David-Alvarez-S/Proyecto-Integrador-de-Competencias-2/Evidencias 1/Cinta/Piñón principal.jpg

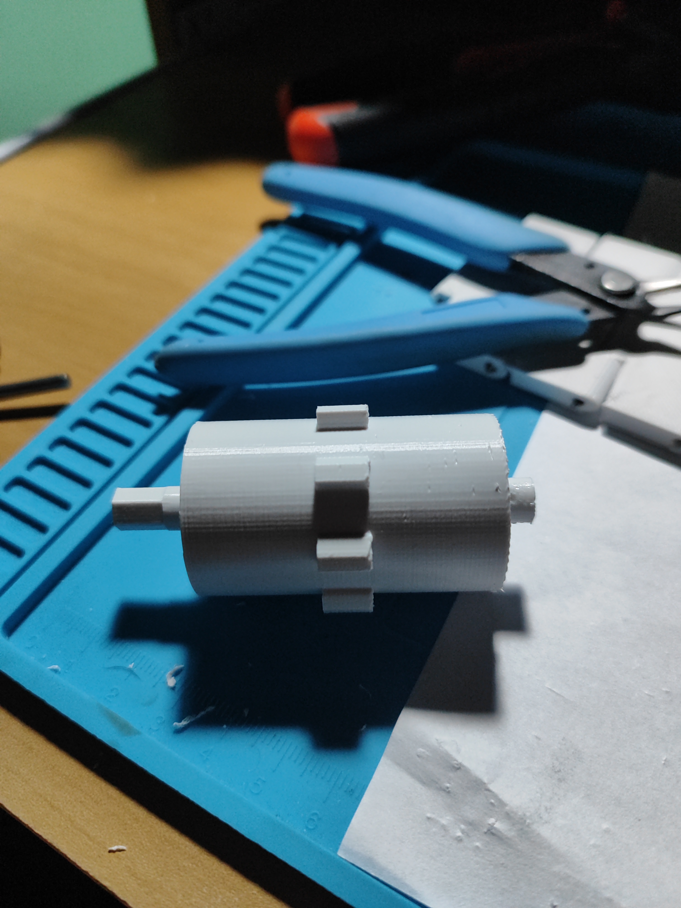
Evidencias 1/Cinta/Piñón principal.jpg
