David-Alvarez-S/Proyecto-Integrador-de-Competencias-2/Evidencias 1/Cinta/Piñón trasero.jpg

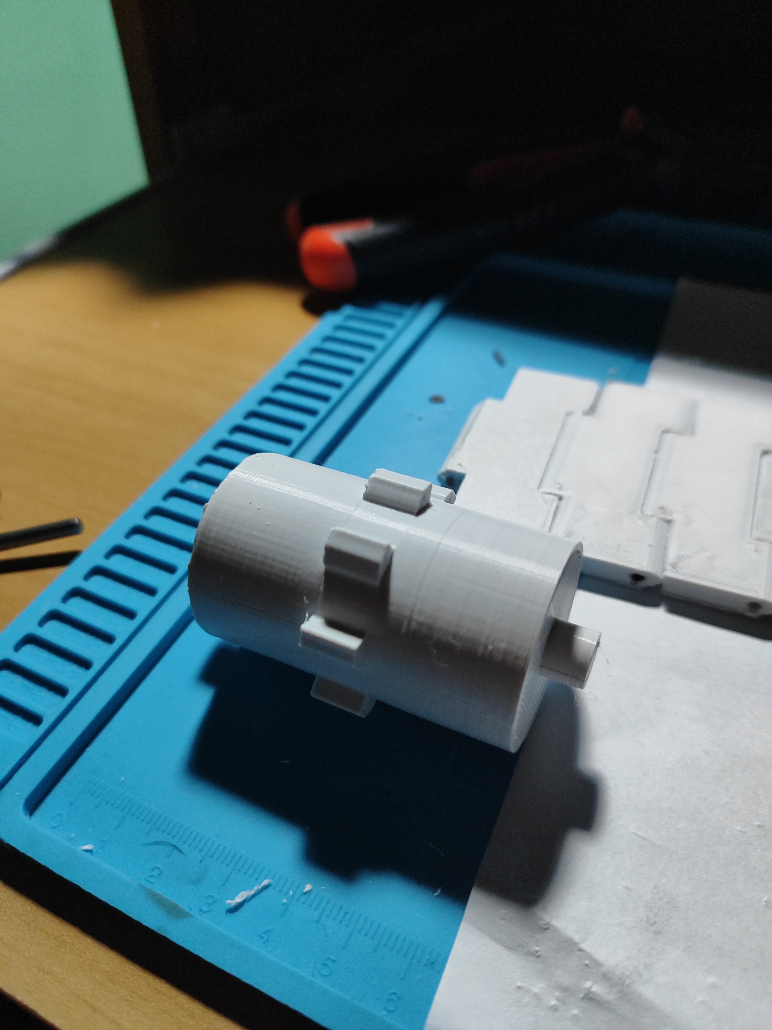
Evidencias 1/Cinta/Piñón trasero.jpg
