David-Alvarez-S/Proyecto-Integrador-de-Competencias-2/Evidencias 1/Contenedor/Marco frontal del contenedor.jpg

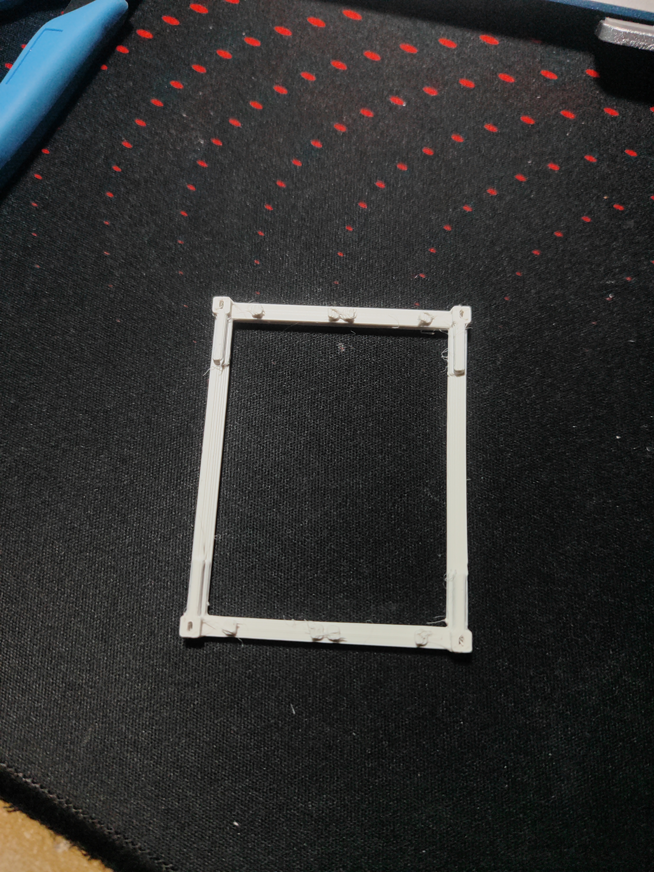
Evidencias 1/Contenedor/Marco frontal del contenedor.jpg
