David-Alvarez-S/Proyecto-Integrador-de-Competencias-2/Evidencias 1/Contenedor/Primer contenedor.jpg

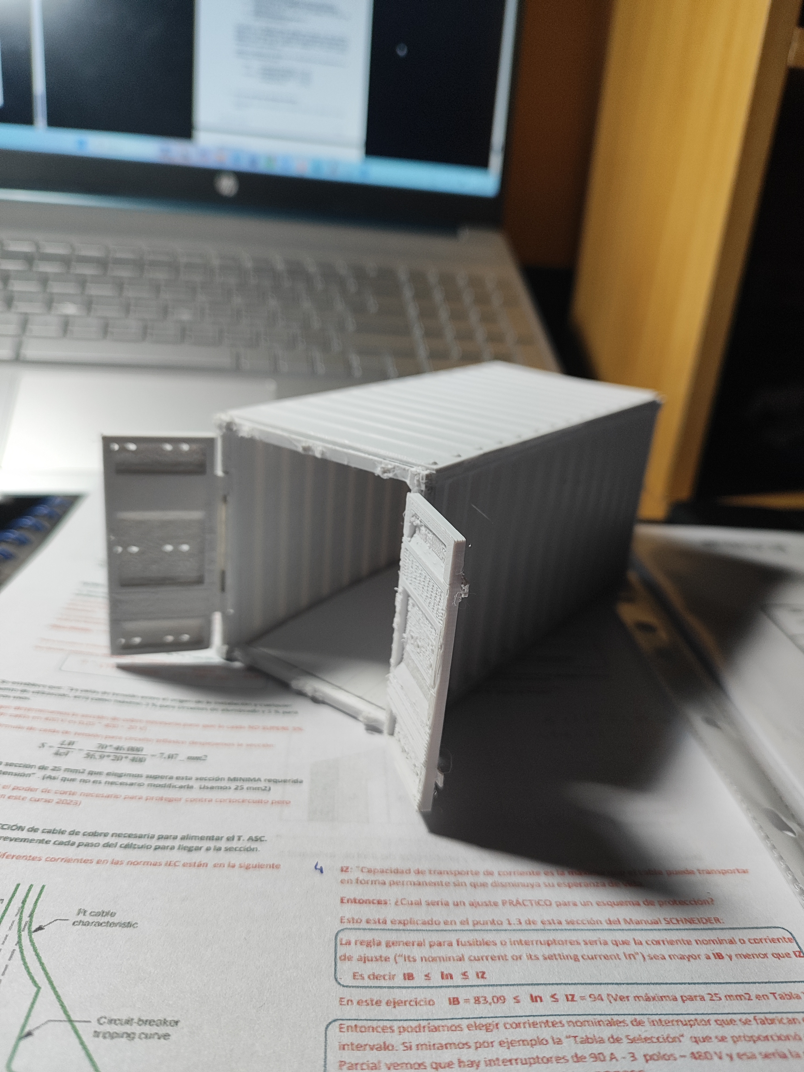
Evidencias 1/Contenedor/Primer contenedor.jpg
