David-Alvarez-S/Proyecto-Integrador-de-Competencias-2/Evidencias 1/Contenedor/Puerta izquierda y derecha del contenedor.jpg

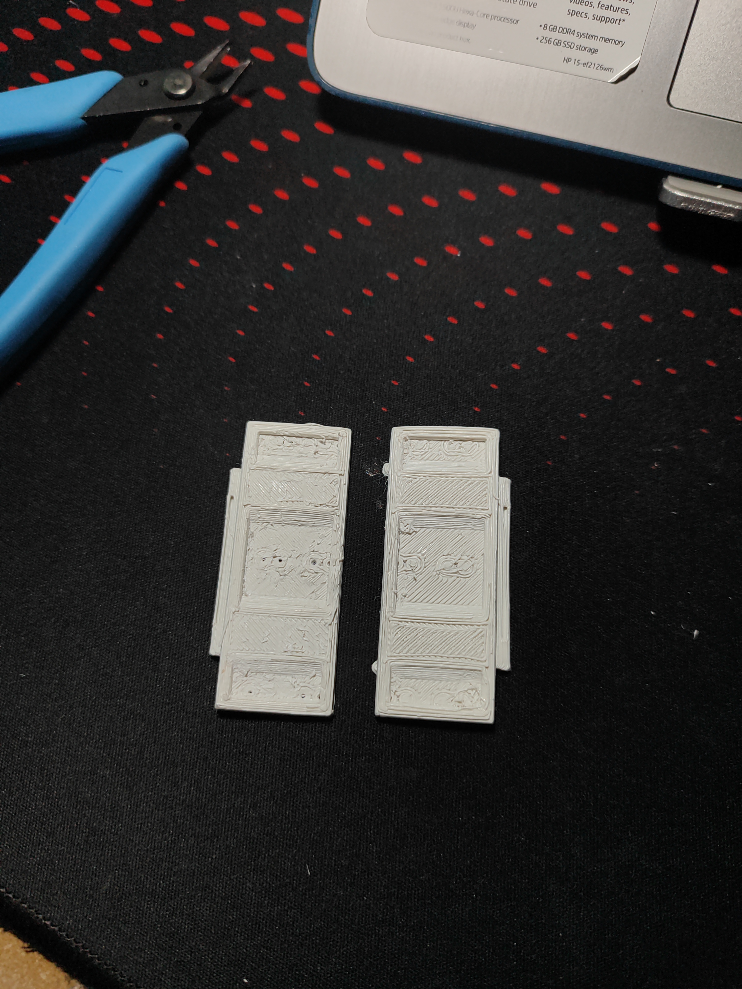
Evidencias 1/Contenedor/Puerta izquierda y derecha del contenedor.jpg
