David-Alvarez-S/Proyecto-Integrador-de-Competencias-2/Evidencias 1/Contenedor/Segundo contenedor.jpg

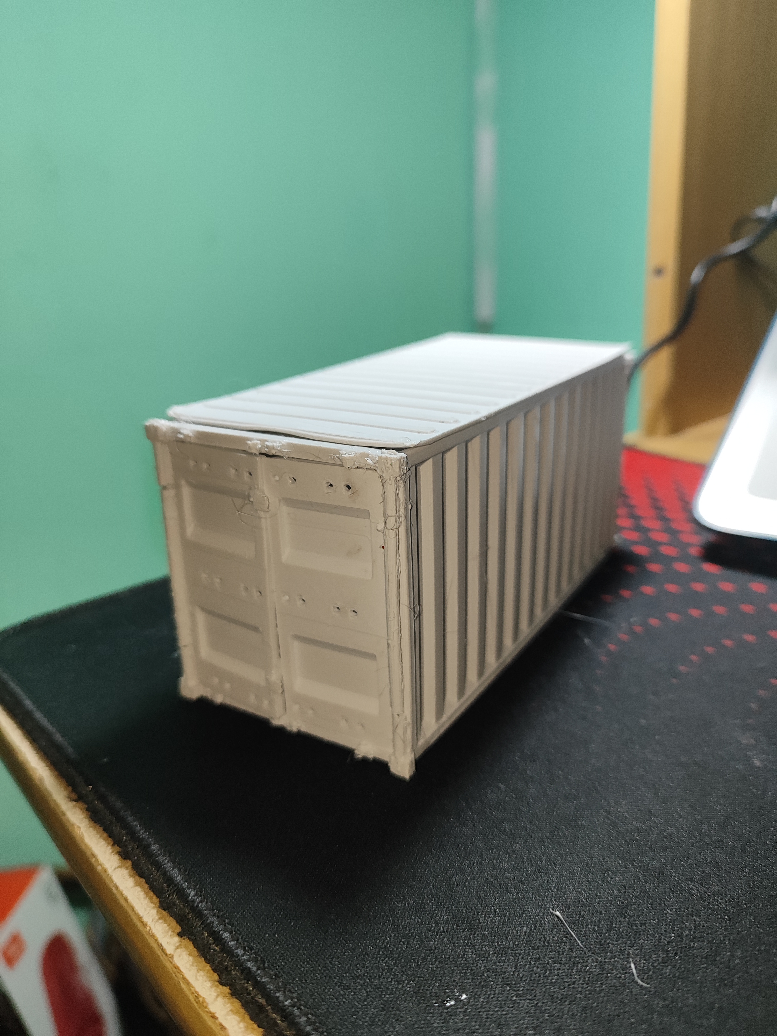
Evidencias 1/Contenedor/Segundo contenedor.jpg
