David-Alvarez-S/Proyecto-Integrador-de-Competencias-2/Evidencias 1/Contenedor/Soportes y piso del contenedor.jpg

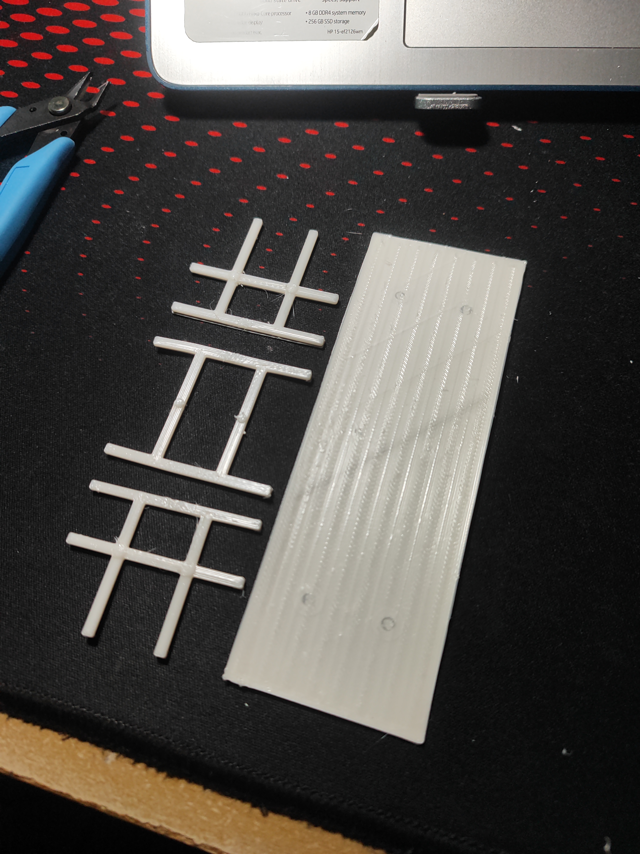
Evidencias 1/Contenedor/Soportes y piso del contenedor.jpg
