David-Alvarez-S/Proyecto-Integrador-de-Competencias-2/Evidencias 1/Diagramas/DiagramadeflujoPIC (1).png

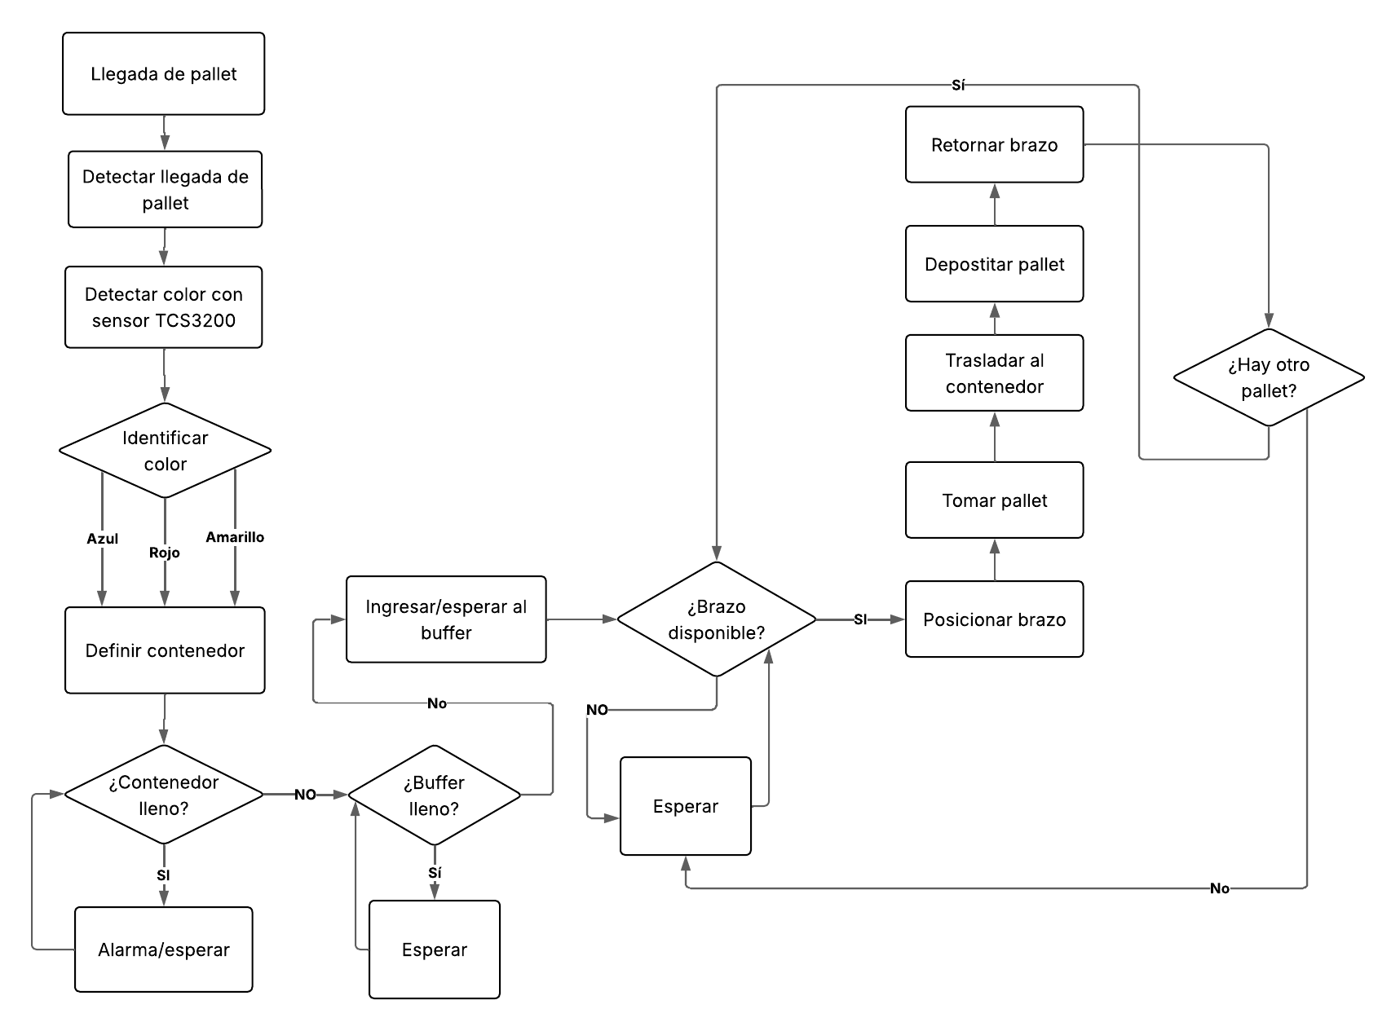
Evidencias 1/Diagramas/DiagramadeflujoPIC (1).png
