David-Alvarez-S/Proyecto-Integrador-de-Competencias-2/Evidencias 1/Diagramas/UMLPIC.drawio.png

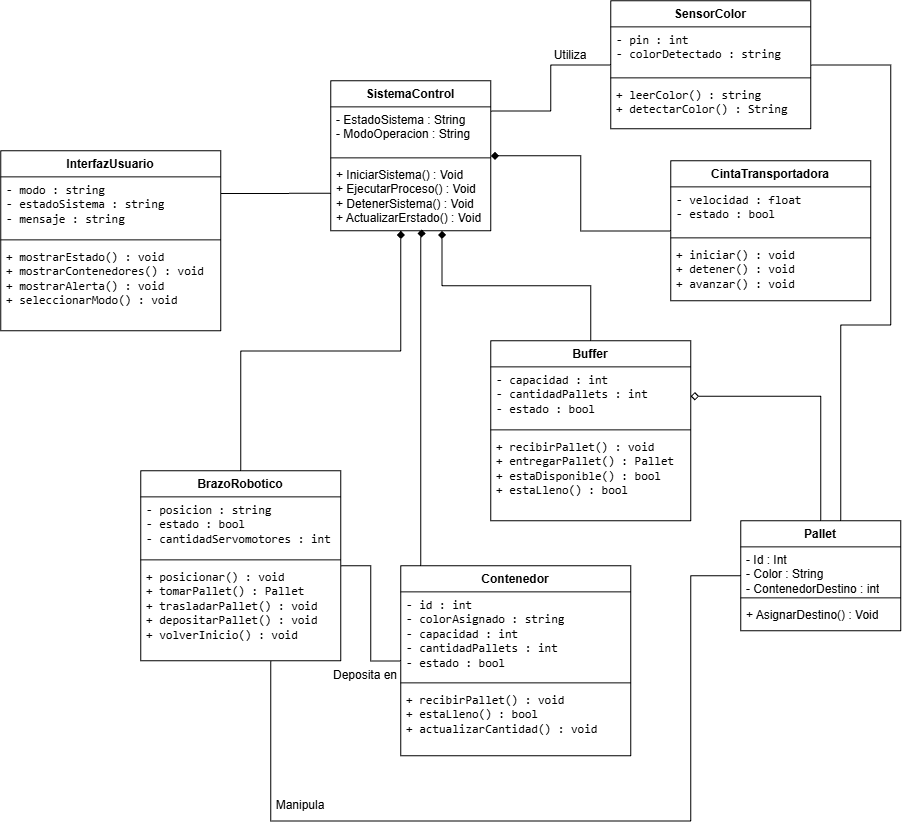
Evidencias 1/Diagramas/UMLPIC.drawio.png
