David-Alvarez-S/Proyecto-Integrador-de-Competencias-2/Evidencias 2/Carcasa de motor paso a paso/Carcasaparteinferior.stl

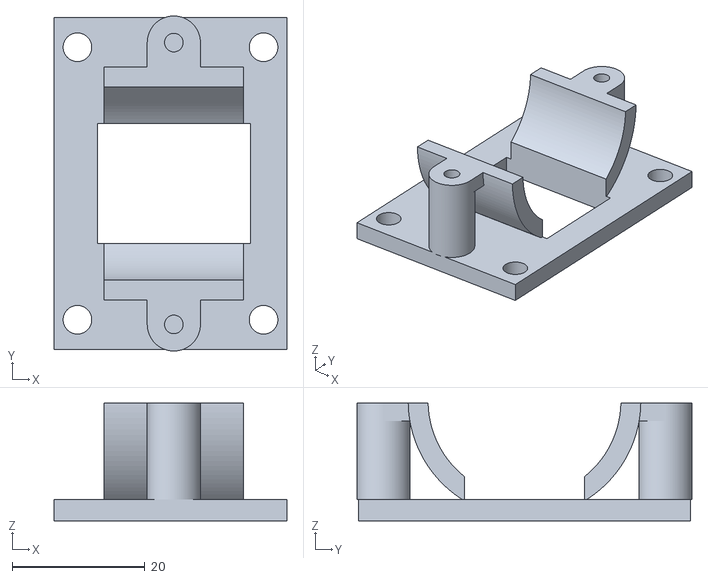
[picture p15: CAD file, 2026-09-30]
Evidencias 2/Carcasa de motor paso a paso/Carcasaparteinferior.stl
35.0 x 50.4 x 17.7
