David-Alvarez-S/Proyecto-Integrador-de-Competencias-2/Evidencias 2/Carcasa de sensor ultra sonido/Tapaultrasonido.stl

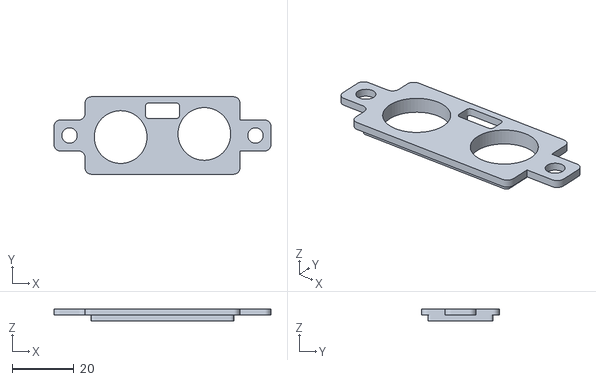
[picture p16: CAD file, 2026-10-01]
Evidencias 2/Carcasa de sensor ultra sonido/Tapaultrasonido.stl
70.0 x 25.0 x 4.00
