David-Alvarez-S/Proyecto-Integrador-de-Competencias-2/Evidencias 2/Carcasa de servo motor/Soportedeservo.stl

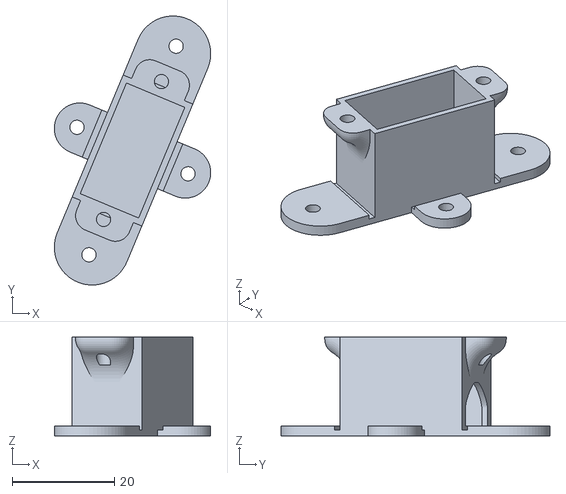
[picture p17: CAD file, 2026-09-30]
Evidencias 2/Carcasa de servo motor/Soportedeservo.stl
30.7 x 52.7 x 19.4
