David-Alvarez-S/Proyecto-Integrador-de-Competencias-2/Modelos 3D/Cinta transportadora/Lateral derecho/lateralderecho215,3.stl

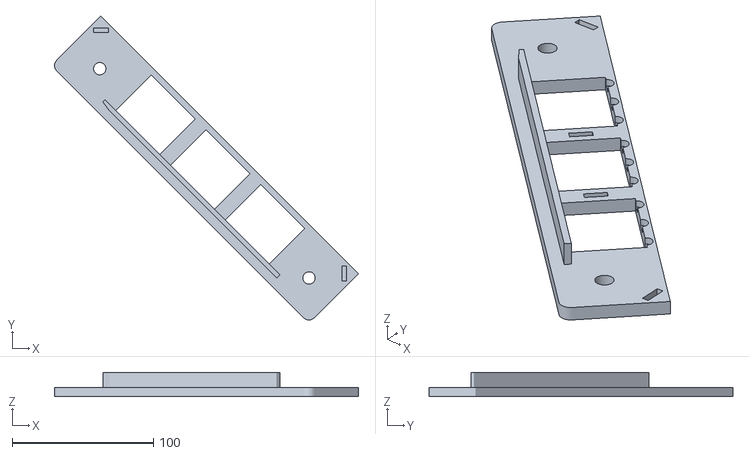
[picture p18: CAD file, 2026-09-14]
Modelos 3D/Cinta transportadora/Lateral derecho/lateralderecho215,3.stl
215.3 x 215.3 x 17.2
