David-Alvarez-S/Proyecto-Integrador-de-Competencias-2/Modelos 3D/Cinta transportadora/Perno/perno.stl

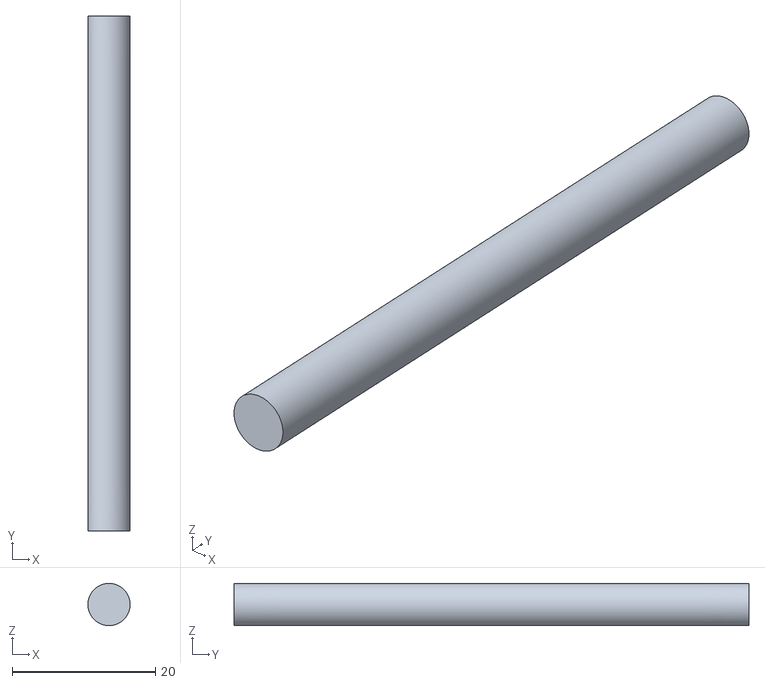
[picture p19: CAD file, 2026-09-14]
Modelos 3D/Cinta transportadora/Perno/perno.stl
5.90 x 72.0 x 5.90
