David-Alvarez-S/Proyecto-Integrador-de-Competencias-2/Modelos 3D/Cinta transportadora/Pieza de cinta/Piezacinta.stl

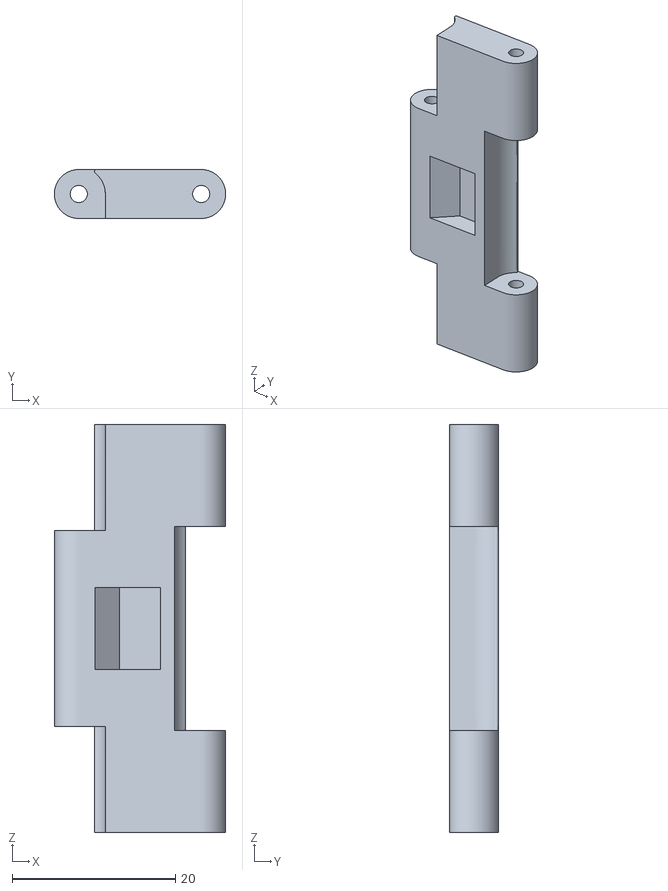
[picture p20: CAD file, 2026-09-14]
Modelos 3D/Cinta transportadora/Pieza de cinta/Piezacinta.stl
21.0 x 6.00 x 50.0
