David-Alvarez-S/Proyecto-Integrador-de-Competencias-2/Modelos 3D/Cinta transportadora/Piñón de cabeza/piñon de cabeza.stl

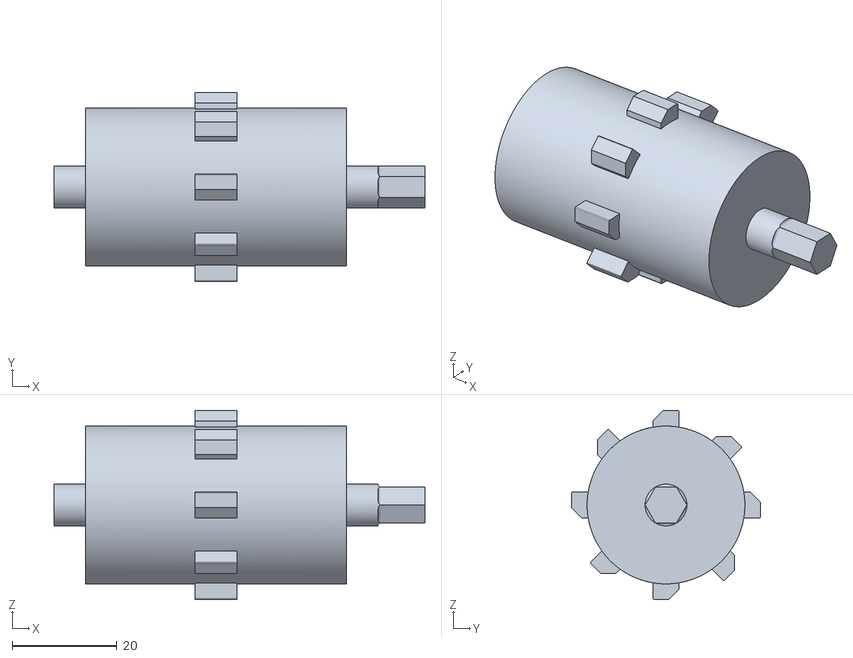
[picture p21: CAD file, 2026-09-14]
Modelos 3D/Cinta transportadora/Piñón de cabeza/piñon de cabeza.stl
71.0 x 36.2 x 36.2
