David-Alvarez-S/Proyecto-Integrador-de-Competencias-2/Modelos 3D/Cinta transportadora/Piñón trasero/piñon trasero.stl

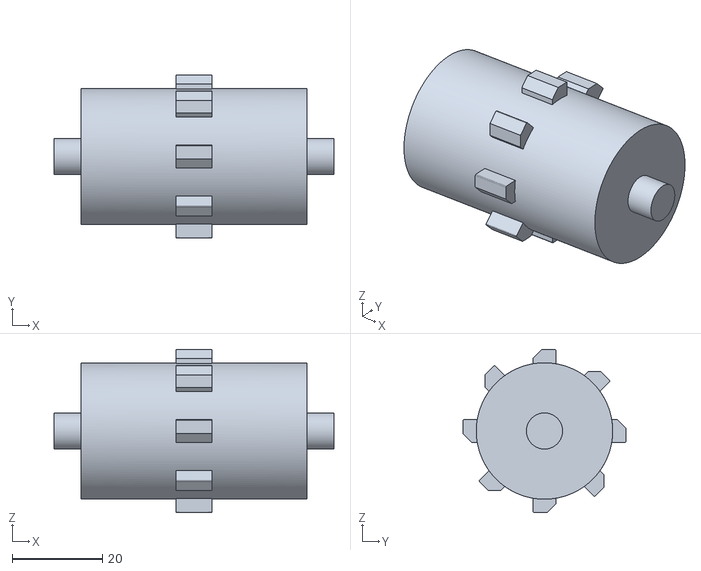
[picture p22: CAD file, 2026-09-14]
Modelos 3D/Cinta transportadora/Piñón trasero/piñon trasero.stl
62.0 x 36.2 x 36.2
