David-Alvarez-S/Proyecto-Integrador-de-Competencias-2/Modelos 3D/Cinta transportadora/Rectángulo soporte/rectangulosoporte.stl

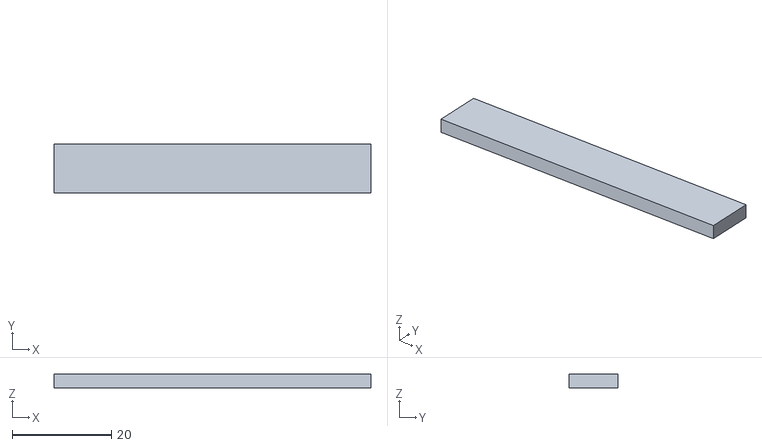
[picture p23: CAD file, 2026-09-14]
Modelos 3D/Cinta transportadora/Rectángulo soporte/rectangulosoporte.stl
64.0 x 9.80 x 2.80
