David-Alvarez-S/Proyecto-Integrador-de-Competencias-2/Modelos 3D/Contenedor/Fondo/fondo.stl

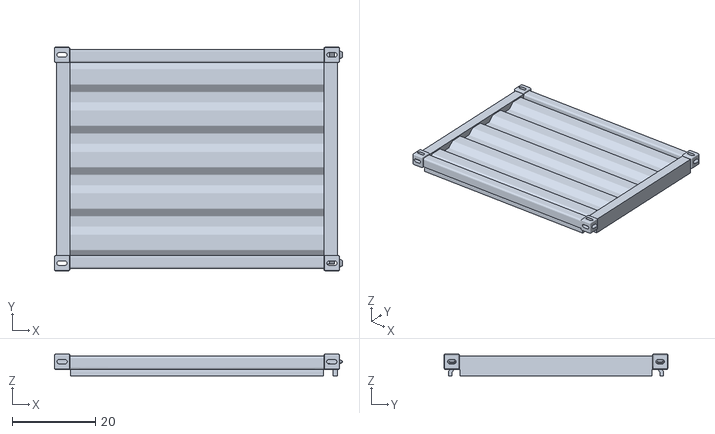
[picture p24: CAD file, 2026-09-10]
Modelos 3D/Contenedor/Fondo/fondo.stl
69.3 x 53.9 x 5.28
