David-Alvarez-S/Proyecto-Integrador-de-Competencias-2/Modelos 3D/Contenedor/Lateral derecho/lateral derecho.stl

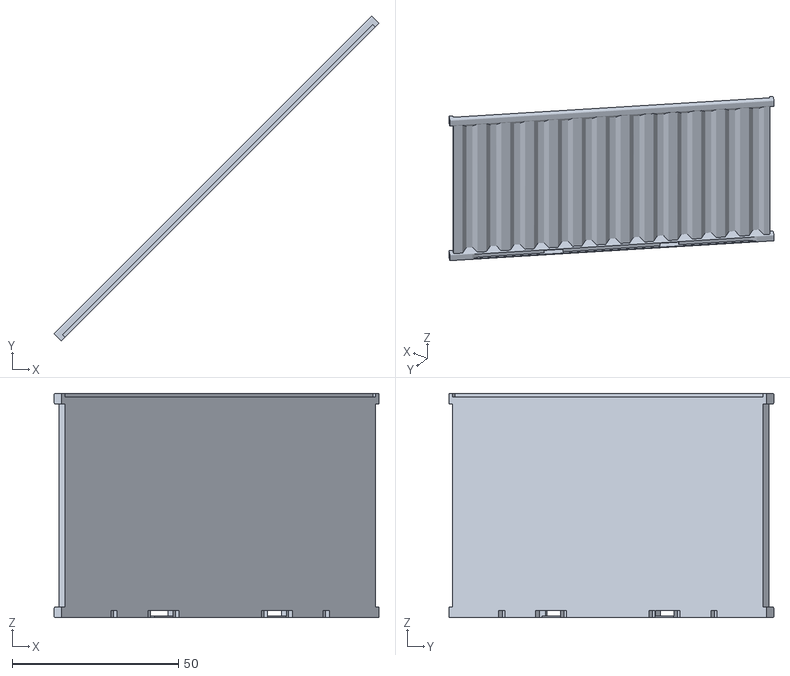
[picture p25: CAD file, 2026-09-10]
Modelos 3D/Contenedor/Lateral derecho/lateral derecho.stl
97.9 x 97.9 x 67.5
