David-Alvarez-S/Proyecto-Integrador-de-Competencias-2/Modelos 3D/Contenedor/Puerta derecha/puerta derecha.stl

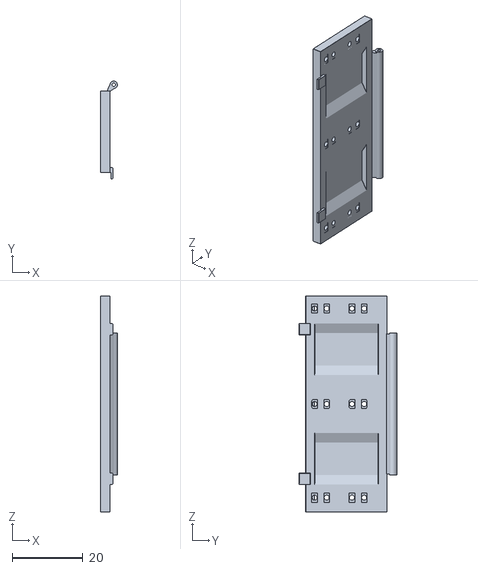
[picture p27: CAD file, 2026-09-10]
Modelos 3D/Contenedor/Puerta derecha/puerta derecha.stl
4.74 x 27.6 x 60.9
