David-Alvarez-S/Proyecto-Integrador-de-Competencias-2/Modelos 3D/Contenedor/Puerta izquierda/puerta izquierda.stl

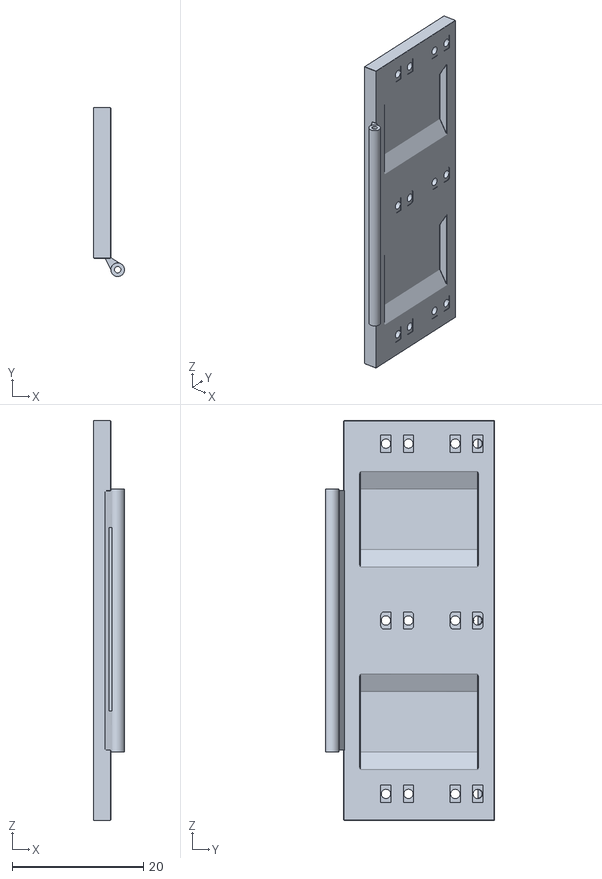
[picture p28: CAD file, 2026-09-10]
Modelos 3D/Contenedor/Puerta izquierda/puerta izquierda.stl
4.74 x 25.8 x 60.9
