David-Alvarez-S/Proyecto-Integrador-de-Competencias-2/Modelos 3D/Contenedor/Soportes y base inferior/soporte delantero.stl

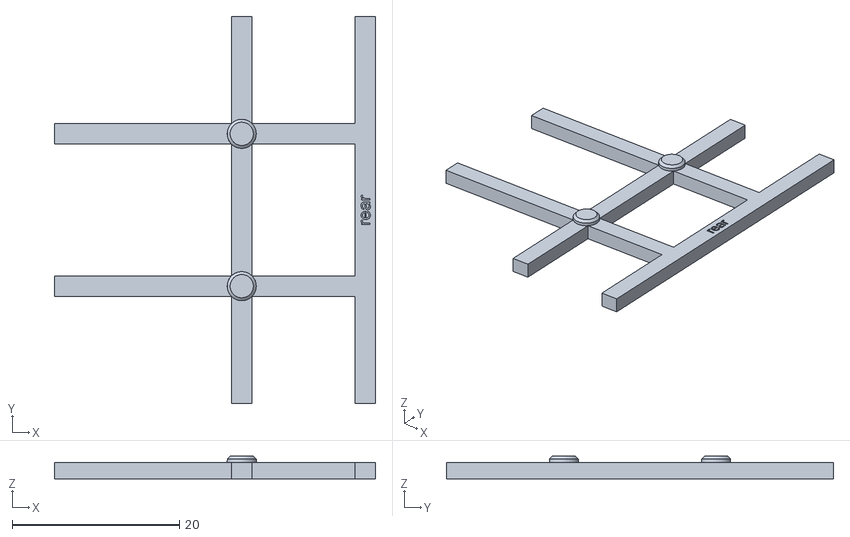
[picture p29: CAD file, 2026-09-10]
Modelos 3D/Contenedor/Soportes y base inferior/soporte delantero.stl
38.4 x 46.2 x 2.70
