David-Alvarez-S/Proyecto-Integrador-de-Competencias-2/Modelos 3D/Contenedor/Techo/techo.stl

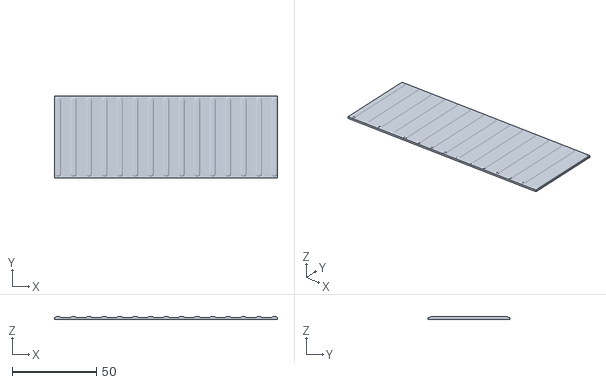
[picture p30: CAD file, 2026-09-10]
Modelos 3D/Contenedor/Techo/techo.stl
132.1 x 48.5 x 1.58
