David-Alvarez-S/Proyecto-Integrador-de-Competencias-2/Modelos 3D/Pallet/Pallet.stl

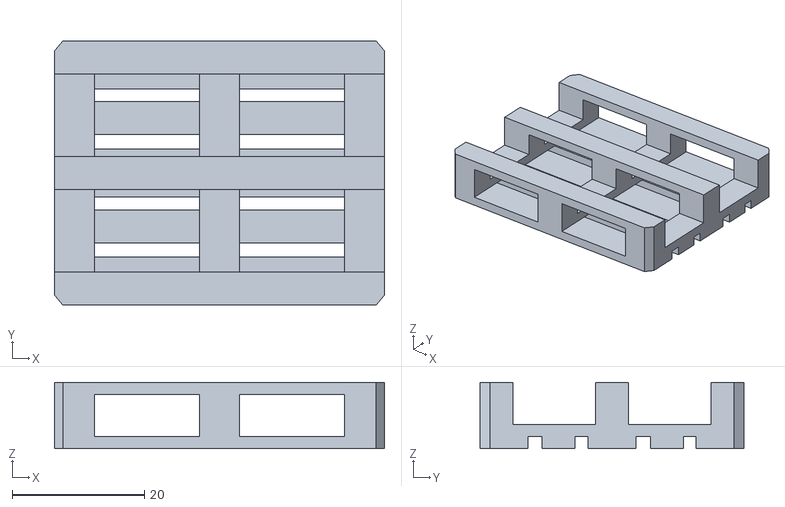
[picture p31: CAD file, 2026-09-10]
Modelos 3D/Pallet/Pallet.stl
50.0 x 40.0 x 10.0
