David-Alvarez-S/Proyecto-Integrador-de-Competencias-2/Modelos 3D/Porta pallets/Porta pallets.stl

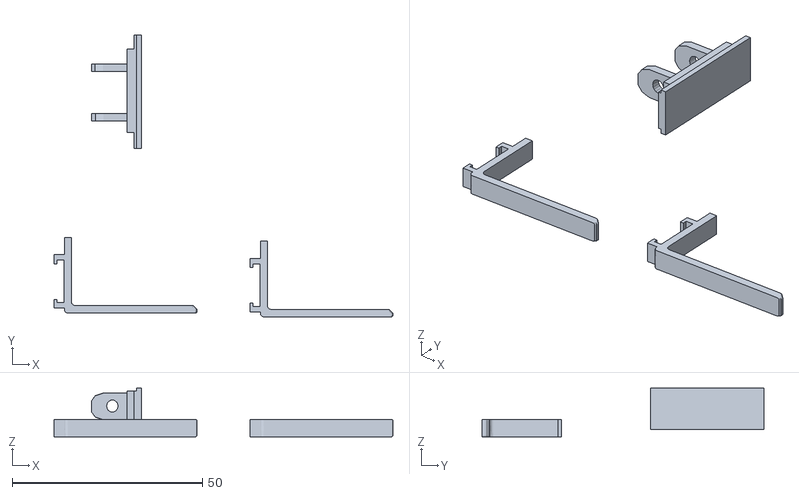
[picture p32: CAD file, 2026-09-10]
Modelos 3D/Porta pallets/Porta pallets.stl
89.0 x 74.0 x 12.8
