David-Alvarez-S/Proyecto-Integrador-de-Competencias-2/Evidencias 2/Carcasa de sensor ultra sonido/Baseultrasonido.stl

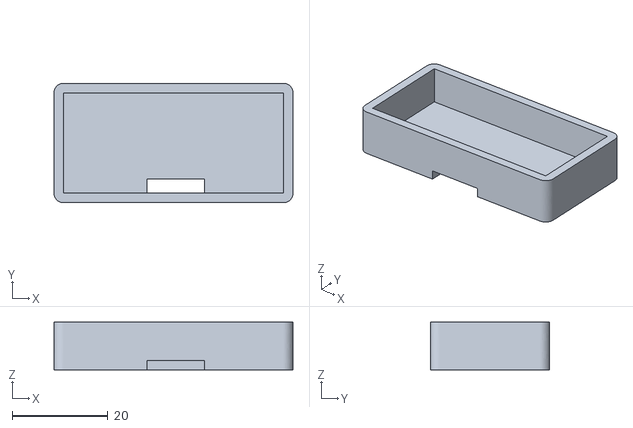
[picture p34: CAD file, 2026-10-01]
Evidencias 2/Carcasa de sensor ultra sonido/Baseultrasonido.stl
50.0 x 25.0 x 10.0
