David-Alvarez-S/Proyecto-Integrador-de-Competencias-2/Modelos 3D/Contenedor/Soportes y base inferior/soporte ultimo.stl

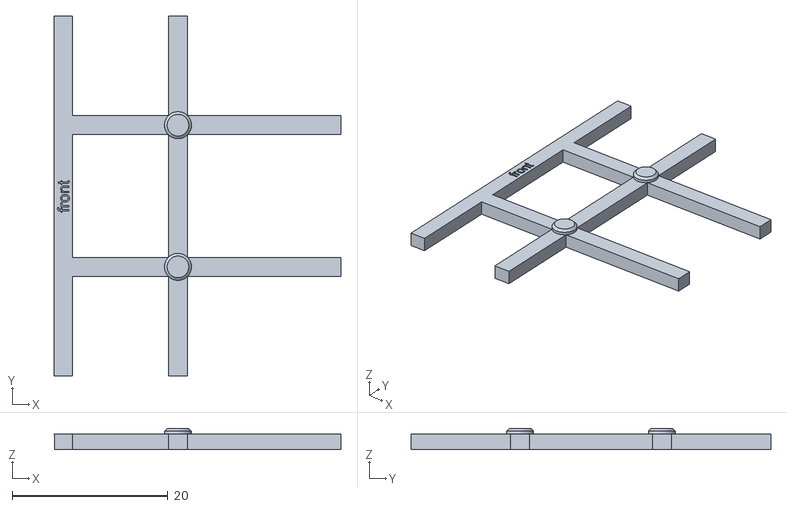
[picture p35: CAD file, 2026-09-10]
Modelos 3D/Contenedor/Soportes y base inferior/soporte ultimo.stl
36.8 x 46.2 x 2.70
