David-Alvarez-S/Proyecto-Integrador-de-Competencias-2/Modelos 3D/Contenedor/Soportes y base inferior/piso interior.stl

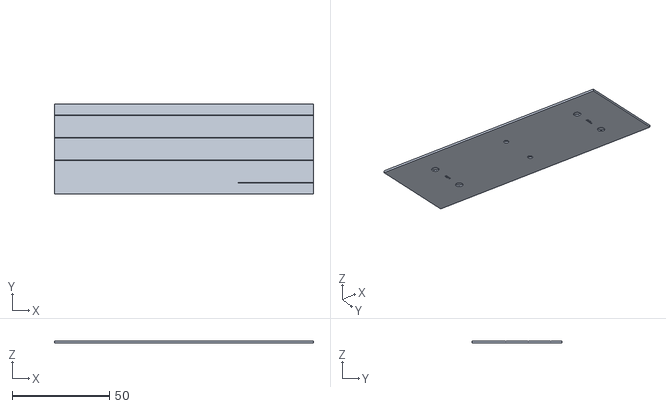
[picture p36: CAD file, 2026-09-10]
Modelos 3D/Contenedor/Soportes y base inferior/piso interior.stl
133.4 x 46.2 x 1.06
