David-Alvarez-S/Proyecto-Integrador-de-Competencias-2/(list of files, cad)

Other CAD files:
Modelos 3D/Cinta transportadora/Lateral izquierdo/lateralizquierdo215,3.stl
Modelos 3D/Contenedor/Lateral izquierdo/lateral izquierdo.stl
Modelos 3D/Contenedor/Soportes y base inferior/soporte medio.stl
Modelos 3D/Pallet/Pallet.f3d
Modelos 3D/Porta pallets/Porta pallets.f3d
