David-Alvarez-S/Proyecto-Integrador-de-Competencias-2/gemelo_digital_ros2/src/Descripcion_Brazo/assembly_1/urdf/assembly_1.urdf

<!--URDF generated by ONSHAPE BY PTC INC, 1.223-->
<robot name="descripcion_brazo/assembly_1">
    <link name="mg90s_servo">
        <inertial>
            <mass value="7.22604e-06" />
            <origin xyz="-0.0110128 -8.5652e-18 -0.00385467" rpy="0 -0 0" />
            <inertia ixx="4.98515e-10" ixy="0" ixz="-3.36919e-11" iyy="7.57509e-10" iyz="0" izz="4.24849e-10" />
        </inertial>
        <visual>
            <origin xyz="-0.0464 0.0003 -0.061" rpy="0 -0 0" />
            <geometry>
                <mesh filename="package://descripcion_brazo/assembly_1/meshes/mg90s_servo.gltf" scale="1 1 1" />
            </geometry>
            <material name="0.615686_0.811765_0.929412_0.000000_0.000000">
                <color rgba="0.615686 0.811765 0.929412 1" />
            </material>
        </visual>
    </link>
    <link name="mg90s_servo_1">
        <inertial>
            <mass value="7.22604e-06" />
            <origin xyz="-0.0110128 -8.5652e-18 -0.00385467" rpy="0 -0 0" />
            <inertia ixx="4.98515e-10" ixy="0" ixz="-3.36919e-11" iyy="7.57509e-10" iyz="0" izz="4.24849e-10" />
        </inertial>
        <visual>
            <origin xyz="-0.0464 0.0003 -0.061" rpy="0 -0 0" />
            <geometry>
                <mesh filename="package://descripcion_brazo/assembly_1/meshes/mg90s_servo.gltf" scale="1 1 1" />
            </geometry>
            <material name="0.615686_0.811765_0.929412_0.000000_0.000000">
                <color rgba="0.615686 0.811765 0.929412 1" />
            </material>
        </visual>
    </link>
    <link name="mg90s_servo_2">
        <inertial>
            <mass value="7.22604e-06" />
            <origin xyz="0.0117872 -5.09575e-18 -0.00385467" rpy="0 -0 0" />
            <inertia ixx="4.98515e-10" ixy="0" ixz="-3.36919e-11" iyy="7.57509e-10" iyz="0" izz="4.24849e-10" />
        </inertial>
        <visual>
            <origin xyz="-0.0236 0.0003 -0.061" rpy="0 -0 0" />
            <geometry>
                <mesh filename="package://descripcion_brazo/assembly_1/meshes/mg90s_servo.gltf" scale="1 1 1" />
            </geometry>
            <material name="0.615686_0.811765_0.929412_0.000000_0.000000">
                <color rgba="0.615686 0.811765 0.929412 1" />
            </material>
        </visual>
    </link>
    <link name="mg90s_servo_3">
        <inertial>
            <mass value="7.22604e-06" />
            <origin xyz="-0.0110128 -8.5652e-18 -0.00385467" rpy="0 -0 0" />
            <inertia ixx="4.98515e-10" ixy="0" ixz="-3.36919e-11" iyy="7.57509e-10" iyz="0" izz="4.24849e-10" />
        </inertial>
        <visual>
            <origin xyz="-0.0464 0.0003 -0.061" rpy="0 -0 0" />
            <geometry>
                <mesh filename="package://descripcion_brazo/assembly_1/meshes/mg90s_servo.gltf" scale="1 1 1" />
            </geometry>
            <material name="0.615686_0.811765_0.929412_0.000000_0.000000">
                <color rgba="0.615686 0.811765 0.929412 1" />
            </material>
        </visual>
    </link>
    <link name="part_1">
        <inertial>
            <mass value="0.0038" />
            <origin xyz="0.0110002 -1.47777e-05 0.000903451" rpy="0 -0 0" />
            <inertia ixx="1.33405e-07" ixy="-7.71669e-12" ixz="4.83833e-11" iyy="1.37752e-07" iyz="7.38176e-12" izz="2.68439e-07" />
        </inertial>
        <visual>
            <origin xyz="0.011 -4.33681e-19 0" rpy="0 -0 0" />
            <geometry>
                <mesh filename="package://descripcion_brazo/assembly_1/meshes/Part_1.gltf" scale="1 1 1" />
            </geometry>
            <material name="0.615686_0.811765_0.929412_0.000000_0.000000">
                <color rgba="0.615686 0.811765 0.929412 1" />
            </material>
        </visual>
    </link>
    <link name="part_1_1">
        <inertial>
            <mass value="8.24638e-06" />
            <origin xyz="9.01269e-07 -0.000747912 0.0125448" rpy="0 -0 0" />
            <inertia ixx="3.49713e-09" ixy="8.36438e-14" ixz="8.69225e-14" iyy="1.98224e-09" iyz="8.78835e-10" izz="2.31895e-09" />
        </inertial>
        <visual>
            <origin xyz="2.81893e-18 0.019 -0.001" rpy="0 -0 0" />
            <geometry>
                <mesh filename="package://descripcion_brazo/assembly_1/meshes/Part_1_1.gltf" scale="1 1 1" />
            </geometry>
            <material name="0.654902_0.823529_0.576471_0.000000_0.000000">
                <color rgba="0.654902 0.823529 0.576471 1" />
            </material>
        </visual>
    </link>
    <link name="part_1_10">
        <inertial>
            <mass value="6.59613e-07" />
            <origin xyz="3.07826e-19 -1.40946e-18 -0.001" rpy="0 0 -1.56788" />
            <inertia ixx="6.61644e-11" ixy="0" ixz="0" iyy="8.77608e-12" iyz="0" izz="7.45007e-11" />
        </inertial>
        <visual>
            <origin xyz="1.25645e-21 -4.30635e-19 -0.002" rpy="0 0 -1.56788" />
            <geometry>
                <mesh filename="package://descripcion_brazo/assembly_1/meshes/Part_1_4.gltf" scale="1 1 1" />
            </geometry>
            <material name="0.262745_0.282353_0.301961_0.000000_0.000000">
                <color rgba="0.262745 0.282353 0.301961 1" />
            </material>
        </visual>
    </link>
    <link name="part_1_11">
        <inertial>
            <mass value="6.59613e-07" />
            <origin xyz="-3.04127e-19 1.41027e-18 0.001" rpy="0 -0 1.57109" />
            <inertia ixx="6.61644e-11" ixy="0" ixz="0" iyy="8.77608e-12" iyz="0" izz="7.45007e-11" />
        </inertial>
        <visual>
            <origin xyz="-1.26413e-22 4.30637e-19 0" rpy="0 -0 1.57109" />
            <geometry>
                <mesh filename="package://descripcion_brazo/assembly_1/meshes/Part_1_4.gltf" scale="1 1 1" />
            </geometry>
            <material name="0.262745_0.282353_0.301961_0.000000_0.000000">
                <color rgba="0.262745 0.282353 0.301961 1" />
            </material>
        </visual>
    </link>
    <link name="part_1_12">
        <inertial>
            <mass value="0.0038" />
            <origin xyz="-0.0109998 -1.47777e-05 0.000903451" rpy="0 -0 0" />
            <inertia ixx="1.33405e-07" ixy="-7.71669e-12" ixz="4.83833e-11" iyy="1.37752e-07" iyz="7.38176e-12" izz="2.68439e-07" />
        </inertial>
        <visual>
            <origin xyz="-0.011 0 0" rpy="0 -0 0" />
            <geometry>
                <mesh filename="package://descripcion_brazo/assembly_1/meshes/Part_1.gltf" scale="1 1 1" />
            </geometry>
            <material name="0.615686_0.811765_0.929412_0.000000_0.000000">
                <color rgba="0.615686 0.811765 0.929412 1" />
            </material>
        </visual>
    </link>
    <link name="part_1_13">
        <inertial>
            <mass value="0.0038" />
            <origin xyz="2.1653e-07 -0.0110148 0.000903451" rpy="0 -0 0" />
            <inertia ixx="1.33405e-07" ixy="-7.71669e-12" ixz="4.83833e-11" iyy="1.37752e-07" iyz="7.38176e-12" izz="2.68439e-07" />
        </inertial>
        <visual>
            <origin xyz="0 -0.011 0" rpy="0 -0 0" />
            <geometry>
                <mesh filename="package://descripcion_brazo/assembly_1/meshes/Part_1.gltf" scale="1 1 1" />
            </geometry>
            <material name="0.615686_0.811765_0.929412_0.000000_0.000000">
                <color rgba="0.615686 0.811765 0.929412 1" />
            </material>
        </visual>
    </link>
    <link name="part_1_2">
        <inertial>
            <mass value="1.192e-05" />
            <origin xyz="-0.00611206 -1.95797e-18 0.0420483" rpy="0 -0 0" />
            <inertia ixx="1.84451e-08" ixy="0" ixz="2.87505e-09" iyy="1.9374e-08" iyz="0" izz="1.96571e-09" />
        </inertial>
        <visual>
            <origin xyz="-0.001 -1.84314e-18 -0.019" rpy="0 -0 0" />
            <geometry>
                <mesh filename="package://descripcion_brazo/assembly_1/meshes/Part_1_2.gltf" scale="1 1 1" />
            </geometry>
            <material name="0.874510_0.447059_0.317647_0.000000_0.000000">
                <color rgba="0.87451 0.447059 0.317647 1" />
            </material>
        </visual>
    </link>
    <link name="part_1_3">
        <inertial>
            <mass value="4.96156e-06" />
            <origin xyz="-0.00143353 -0.00249589 0.0233026" rpy="0 -0 0" />
            <inertia ixx="3.22542e-09" ixy="-8.2316e-13" ixz="7.68533e-12" iyy="3.0733e-09" iyz="3.6092e-10" izz="2.8758e-10" />
        </inertial>
        <visual>
            <origin xyz="-0.003 1.53081e-19 0" rpy="0 -0 0" />
            <geometry>
                <mesh filename="package://descripcion_brazo/assembly_1/meshes/Part_1_3.gltf" scale="1 1 1" />
            </geometry>
            <material name="0.760784_0.839216_0.925490_0.000000_0.000000">
                <color rgba="0.760784 0.839216 0.92549 1" />
            </material>
        </visual>
    </link>
    <link name="part_1_4">
        <inertial>
            <mass value="6.59613e-07" />
            <origin xyz="1.41044e-18 3.03308e-19 -0.001" rpy="0 0 -0.00028709" />
            <inertia ixx="6.61644e-11" ixy="0" ixz="0" iyy="8.77608e-12" iyz="0" izz="7.45007e-11" />
        </inertial>
        <visual>
            <origin xyz="4.30637e-19 -1.23632e-22 -0.002" rpy="0 0 -0.00028709" />
            <geometry>
                <mesh filename="package://descripcion_brazo/assembly_1/meshes/Part_1_4.gltf" scale="1 1 1" />
            </geometry>
            <material name="0.262745_0.282353_0.301961_0.000000_0.000000">
                <color rgba="0.262745 0.282353 0.301961 1" />
            </material>
        </visual>
    </link>
    <link name="part_1_5">
        <inertial>
            <mass value="1.2756e-05" />
            <origin xyz="0.00112439 0.00222137 0.0392417" rpy="0 -0 0" />
            <inertia ixx="2.12673e-08" ixy="-3.80215e-10" ixz="-5.47157e-09" iyy="2.39359e-08" iyz="-1.36345e-09" izz="4.73606e-09" />
        </inertial>
        <visual>
            <origin xyz="-0.001 -4.3097e-18 -0.019" rpy="0 -0 0" />
            <geometry>
                <mesh filename="package://descripcion_brazo/assembly_1/meshes/Part_1_5.gltf" scale="1 1 1" />
            </geometry>
            <material name="0.764706_0.545098_0.803922_0.000000_0.000000">
                <color rgba="0.764706 0.545098 0.803922 1" />
            </material>
        </visual>
    </link>
    <link name="part_1_6">
        <inertial>
            <mass value="0.0038" />
            <origin xyz="-3.47966e-06 -1.38568e-06 0.000903451" rpy="0 -0 0" />
            <inertia ixx="1.33405e-07" ixy="-7.71669e-12" ixz="4.83833e-11" iyy="1.37752e-07" iyz="7.38176e-12" izz="2.68439e-07" />
        </inertial>
        <visual>
            <origin xyz="-3.6962e-06 1.3392e-05 0" rpy="0 -0 0" />
            <geometry>
                <mesh filename="package://descripcion_brazo/assembly_1/meshes/Part_1.gltf" scale="1 1 1" />
            </geometry>
            <material name="0.615686_0.811765_0.929412_0.000000_0.000000">
                <color rgba="0.615686 0.811765 0.929412 1" />
            </material>
        </visual>
    </link>
    <link name="part_1_7">
        <inertial>
            <mass value="2.71405e-06" />
            <origin xyz="-1.89729e-18 -0.00104233 0.0181553" rpy="0 -0 0" />
            <inertia ixx="7.05277e-10" ixy="0" ixz="0" iyy="6.8784e-10" iyz="-1.35621e-10" izz="1.49349e-10" />
        </inertial>
        <visual>
            <origin xyz="-2.60209e-18 -0.0085 -0.003" rpy="0 -0 0" />
            <geometry>
                <mesh filename="package://descripcion_brazo/assembly_1/meshes/Part_1_6.gltf" scale="1 1 1" />
            </geometry>
            <material name="0.537255_0.854902_0.827451_0.000000_0.000000">
                <color rgba="0.537255 0.854902 0.827451 1" />
            </material>
        </visual>
    </link>
    <link name="part_1_8">
        <inertial>
            <mass value="2.42309e-05" />
            <origin xyz="-0.00448012 -2.42589e-07 -0.003443" rpy="0 -0 0" />
            <inertia ixx="1.24766e-08" ixy="-6.87656e-15" ixz="-5.61196e-10" iyy="1.33197e-08" iyz="-5.37657e-14" izz="2.29397e-08" />
        </inertial>
        <visual>
            <origin xyz="0 0 0" rpy="0 -0 0" />
            <geometry>
                <mesh filename="package://descripcion_brazo/assembly_1/meshes/Part_1_7.gltf" scale="1 1 1" />
            </geometry>
            <material name="0.647059_0.647059_0.647059_0.000000_0.000000">
                <color rgba="0.647059 0.647059 0.647059 1" />
            </material>
        </visual>
    </link>
    <link name="part_1_9">
        <inertial>
            <mass value="6.59613e-07" />
            <origin xyz="3.0453e-19 -1.41018e-18 -0.001" rpy="0 0 -1.57022" />
            <inertia ixx="6.61644e-11" ixy="0" ixz="0" iyy="8.77608e-12" iyz="0" izz="7.45007e-11" />
        </inertial>
        <visual>
            <origin xyz="2.49476e-22 -4.30637e-19 -0.002" rpy="0 0 -1.57022" />
            <geometry>
                <mesh filename="package://descripcion_brazo/assembly_1/meshes/Part_1_4.gltf" scale="1 1 1" />
            </geometry>
            <material name="0.262745_0.282353_0.301961_0.000000_0.000000">
                <color rgba="0.262745 0.282353 0.301961 1" />
            </material>
        </visual>
    </link>
    <link name="root" />
    <joint name="fastened_1" type="fixed">
        <origin xyz="0.0115 -1.68051e-18 0.003" rpy="0 -0 -3.14159" />
        <axis xyz="0 -1 0" />
        <parent link="part_1_8" />
        <child link="mg90s_servo_2" />
    </joint>
    <joint name="fastened_10" type="fixed">
        <origin xyz="-0.019 -1.10071e-05 3.46945e-18" rpy="0 -1.5708 0.000579319" />
        <axis xyz="0 0 -1" />
        <parent link="part_1_9" />
        <child link="part_1_2" />
    </joint>
    <joint name="fastened_11" type="fixed">
        <origin xyz="-4.15588e-16 -5.55112e-17 -0.002" rpy="0 -1.5708 1.57051" />
        <axis xyz="-1 0 0" />
        <parent link="part_1_4" />
        <child link="part_1_3" />
    </joint>
    <joint name="fastened_12" type="fixed">
        <origin xyz="-0.001 1.01578e-15 0.096" rpy="0 -1.5708 -3.09264e-16" />
        <axis xyz="0 0 -1" />
        <parent link="part_1_2" />
        <child link="mg90s_servo_1" />
    </joint>
    <joint name="fastened_14" type="fixed">
        <origin xyz="-0.025 3.2793e-16 0.102073" rpy="0 1.5708 1.49084e-16" />
        <axis xyz="1 -1.16424e-16 -0" />
        <parent link="part_1_2" />
        <child link="part_1" />
    </joint>
    <joint name="fastened_15" type="fixed">
        <origin xyz="0.027 2.4626e-16 0.086735" rpy="0 -1.5708 -1.44704e-15" />
        <axis xyz="0 0 -1" />
        <parent link="part_1_5" />
        <child link="part_1_6" />
    </joint>
    <joint name="fastened_2" type="fixed">
        <origin xyz="-0.0189999 -5.54354e-05 0" rpy="-6.16298e-32 -6.14502e-32 -1.56788" />
        <axis xyz="1 0 0" />
        <parent link="part_1_10" />
        <child link="part_1_1" />
    </joint>
    <joint name="fastened_3" type="fixed">
        <origin xyz="1.40166e-18 6.93889e-18 0.04215" rpy="1.5708 4.85723e-17 -2.22045e-16" />
        <axis xyz="-0 -0 -1" />
        <parent link="part_1_7" />
        <child link="part_1_13" />
    </joint>
    <joint name="fastened_4" type="fixed">
        <origin xyz="0.0255 8.67362e-19 0.0255" rpy="1.5708 -0 -1.5708" />
        <axis xyz="-0 -1 -0" />
        <parent link="part_1_8" />
        <child link="part_1_7" />
    </joint>
    <joint name="fastened_5" type="fixed">
        <origin xyz="-2.51061e-18 0.0015 0.037" rpy="0 -1.5708 4.71239" />
        <axis xyz="0 -1 0" />
        <parent link="part_1_1" />
        <child link="mg90s_servo" />
    </joint>
    <joint name="fastened_6" type="fixed">
        <origin xyz="0.019 5.57745e-06 1.73472e-18" rpy="0 1.5708 0.00029355" />
        <axis xyz="-1 0 0" />
        <parent link="part_1_11" />
        <child link="part_1_5" />
    </joint>
    <joint name="fastened_8" type="fixed">
        <origin xyz="0.002 4.60549e-17 0.093" rpy="0 -1.5708 3.14159" />
        <axis xyz="0 0 -1" />
        <parent link="part_1_5" />
        <child link="mg90s_servo_3" />
    </joint>
    <joint name="fastened_9" type="fixed">
        <origin xyz="-9.52065e-19 -0.0187 0.04235" rpy="0 -1.5708 1.5708" />
        <axis xyz="-0 -0 -1" />
        <parent link="part_1_1" />
        <child link="part_1_12" />
    </joint>
    <joint name="fixed_node_to_root_joint" type="fixed">
        <origin xyz="0 0 0" rpy="0 -0 0" />
        <axis xyz="0 0 1" />
        <parent link="root" />
        <child link="part_1_8" />
    </joint>
    <joint name="revolute_1" type="continuous">
        <origin xyz="0.01715 -1.02259e-18 0.0145" rpy="8.35204e-16 1.63256e-16 3.14159" />
        <axis xyz="0 0 -1" />
        <parent link="mg90s_servo_2" />
        <child link="part_1_10" />
    </joint>
    <joint name="revolute_2" type="continuous">
        <origin xyz="-0.00565 -4.16401e-18 0.0145" rpy="-3.14159 -6.42975e-17 -2.01023e-16" />
        <axis xyz="0 0 -1" />
        <parent link="mg90s_servo" />
        <child link="part_1_11" />
    </joint>
    <joint name="revolute_3" type="continuous">
        <origin xyz="-0.00565 -2.51561e-16 0.0145" rpy="4.68367e-17 -5.84448e-16 3.14159" />
        <axis xyz="0 0 1" />
        <parent link="mg90s_servo_3" />
        <child link="part_1_9" />
    </joint>
    <joint name="revolute_4" type="continuous">
        <origin xyz="-0.00565 -3.63208e-18 0.0145" rpy="3.14159 1.44227e-16 -1.5708" />
        <axis xyz="0 0 -1" />
        <parent link="mg90s_servo_1" />
        <child link="part_1_4" />
    </joint>
</robot>
