David-Alvarez-S/Proyecto-Integrador-de-Competencias-2/Modelos 3D/Pallet/Plano de pallet.pdf

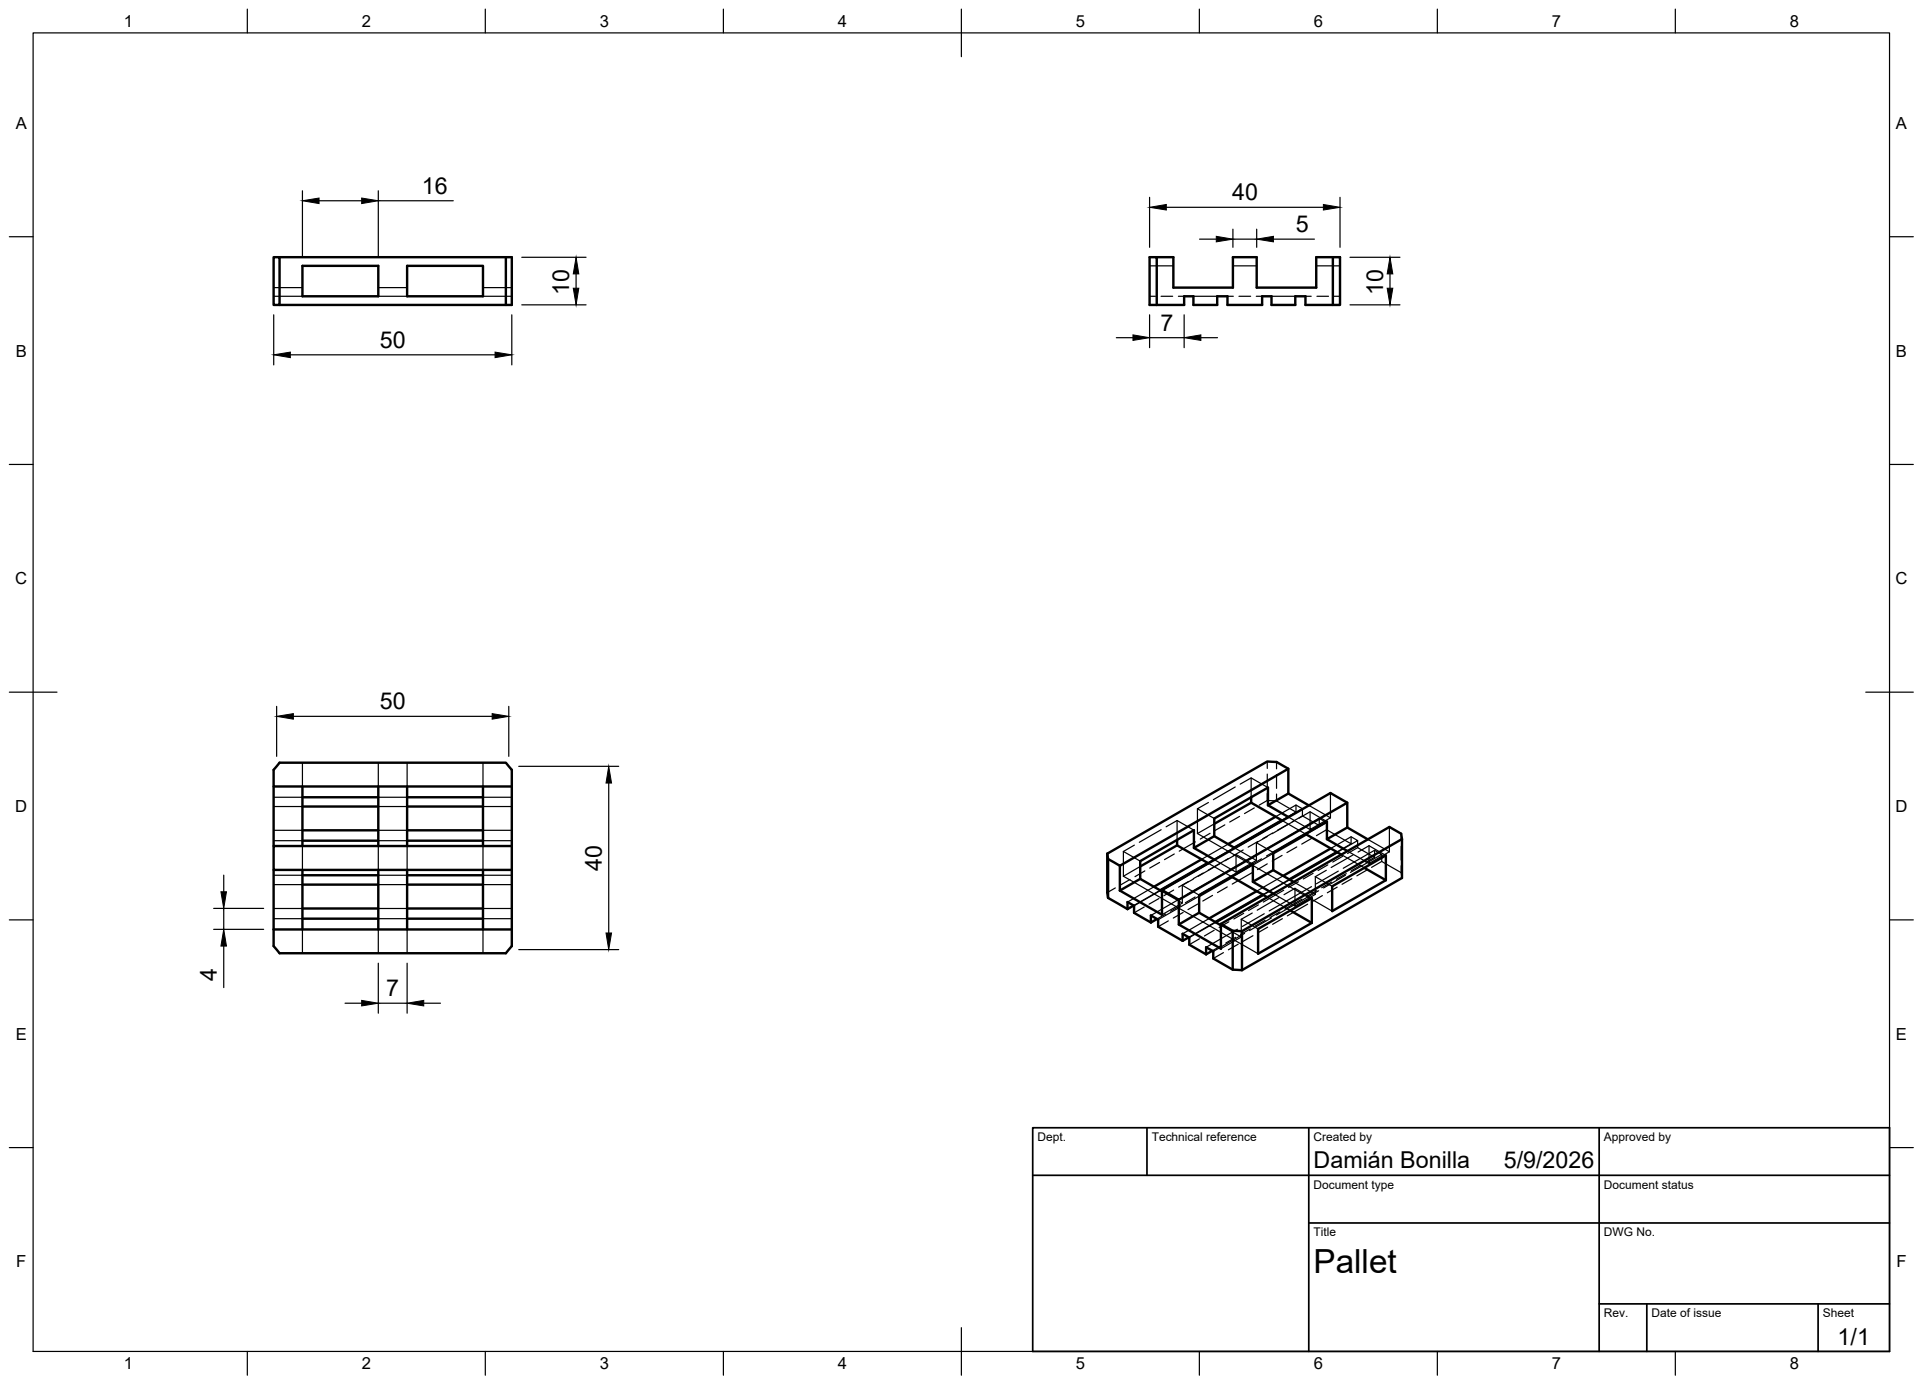
[picture p37: page 1]
Title; DWG No.; Rev.; Date of issue; Sheet; Damián Bonilla 10

Dept. | Technical reference | Created by 5/9/2026 | Approved by

Document type | Document status
