David-Alvarez-S/Proyecto-Integrador-de-Competencias-2/codigo/PlatformIO_code/include/Drivers/tft_font5x7.h

#ifndef TFT_FONT5X7_H
#define TFT_FONT5X7_H

#ifdef __cplusplus
extern "C" {
#endif

#include <stdint.h>

#define TFT_FONT_GLYPH_W 5
#define TFT_FONT_CELL_W 6
#define TFT_FONT_CELL_H 8

static inline const uint8_t *tft_font5x7_glyph(char c) {
  static const uint8_t font[95][5] = {
      {0x00, 0x00, 0x00, 0x00, 0x00}, /* ' ' */
      {0x00, 0x00, 0x5F, 0x00, 0x00}, /* ! */
      {0x00, 0x07, 0x00, 0x07, 0x00}, /* " */
      {0x14, 0x7F, 0x14, 0x7F, 0x14}, /* # */
      {0x24, 0x2A, 0x7F, 0x2A, 0x12}, /* $ */
      {0x23, 0x13, 0x08, 0x64, 0x62}, /* % */
      {0x36, 0x49, 0x56, 0x20, 0x50}, /* & */
      {0x00, 0x08, 0x07, 0x03, 0x00}, /* ' */
      {0x00, 0x1C, 0x22, 0x41, 0x00}, /* ( */
      {0x00, 0x41, 0x22, 0x1C, 0x00}, /* ) */
      {0x2A, 0x1C, 0x7F, 0x1C, 0x2A}, /* * */
      {0x08, 0x08, 0x3E, 0x08, 0x08}, /* + */
      {0x00, 0x80, 0x70, 0x30, 0x00}, /* , */
      {0x08, 0x08, 0x08, 0x08, 0x08}, /* - */
      {0x00, 0x00, 0x60, 0x60, 0x00}, /* . */
      {0x20, 0x10, 0x08, 0x04, 0x02}, /* / */
      {0x3E, 0x51, 0x49, 0x45, 0x3E}, /* 0 */
      {0x00, 0x42, 0x7F, 0x40, 0x00}, /* 1 */
      {0x72, 0x49, 0x49, 0x49, 0x46}, /* 2 */
      {0x21, 0x41, 0x49, 0x4D, 0x33}, /* 3 */
      {0x18, 0x14, 0x12, 0x7F, 0x10}, /* 4 */
      {0x27, 0x45, 0x45, 0x45, 0x39}, /* 5 */
      {0x3C, 0x4A, 0x49, 0x49, 0x31}, /* 6 */
      {0x41, 0x21, 0x11, 0x09, 0x07}, /* 7 */
      {0x36, 0x49, 0x49, 0x49, 0x36}, /* 8 */
      {0x46, 0x49, 0x49, 0x29, 0x1E}, /* 9 */
      {0x00, 0x00, 0x14, 0x00, 0x00}, /* : */
      {0x00, 0x40, 0x34, 0x00, 0x00}, /* ; */
      {0x00, 0x08, 0x14, 0x22, 0x41}, /* < */
      {0x14, 0x14, 0x14, 0x14, 0x14}, /* = */
      {0x00, 0x41, 0x22, 0x14, 0x08}, /* > */
      {0x02, 0x01, 0x59, 0x09, 0x06}, /* ? */
      {0x3E, 0x41, 0x5D, 0x59, 0x4E}, /* @ */
      {0x7C, 0x12, 0x11, 0x12, 0x7C}, /* A */
      {0x7F, 0x49, 0x49, 0x49, 0x36}, /* B */
      {0x3E, 0x41, 0x41, 0x41, 0x22}, /* C */
      {0x7F, 0x41, 0x41, 0x41, 0x3E}, /* D */
      {0x7F, 0x49, 0x49, 0x49, 0x41}, /* E */
      {0x7F, 0x09, 0x09, 0x09, 0x01}, /* F */
      {0x3E, 0x41, 0x41, 0x51, 0x73}, /* G */
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
  };
  if (c < 32 || c > 126) {
    c = '?';
  }
  return font[c - 32];
}

#ifdef __cplusplus
}
#endif

#endif /* TFT_FONT5X7_H */
