David-Alvarez-S/Proyecto-Integrador-de-Competencias-2/(commit log)

2026-09-10 Se añaden modelos 3D
    [Pallet.f3d, Pallet.stl, Porta pallets.f3d, Porta pallets.stl, fondo.stl, lateral derecho.stl, lateral izquierdo.stl, marco frontal.stl]
2026-09-22 Se agrego prototipo del brazo robotico con RViz2 usando ROS2 Jazzy
    [Brazo.urdf]
2026-09-25 Se agregan simulacion de gemelo digital mediante vectores de posicion por CLI
    [Brazo.urdf]
2026-09-27 Correcion de errores de IK
    [Brazo.urdf]
2026-09-30 Create Carcasa de motor paso a paso.gitkeep
2026-09-30 Create Carcasa de ServoMotor.gitkeep
2026-09-30 Create Carcasa de ServoMotor
2026-09-30 Carcasa de Servo Motor .gitkeep
2026-10-01 Carcasa de sensor ultrasonido
2026-10-31 Incorporacion de Interfaz Grafica
2026-10-31 Se Actualizo el Gemelo Digial
